potladhruval/Beamsteering_Network/README.md

# Beamsteering_Network
This project consists of beamforming array design consisting of the network of Phase shifters, Low Noise Amplifiers, and Via-fed Patch antennas to form the building blocks of the beamsteering network
