potladhruval/Beamsteering_Network/Via-Fed Patch antenna/Patch Antenna Design Project.pdf

## Patch Antenna Design Project August 21, 2023 Dhruval Potla, student

## Assignment

## Design

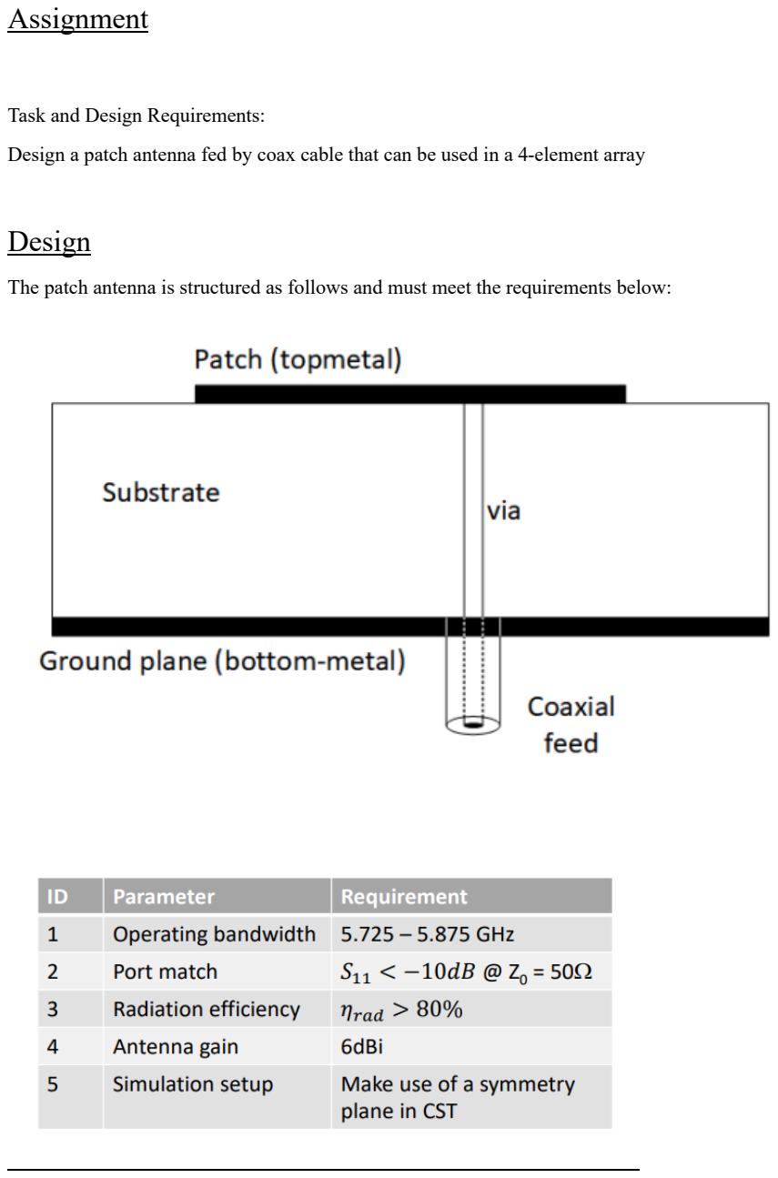
[picture p1: page 2]

Task and Design Requirements:

Design a patch antenna fed by coax cable that can be used in a 4-element array

The patch antenna is structured as follows and must meet the requirements below:

The design equations are as follows as found at www.everythingrf.com/microstrip-patch-antennacalculator:

The Microstrip Patch Antenna Calculation Process

Step 1: Calculation of the Width (W) -
Step 2: Calculation of the Effective Dielectric Constant. This is based on the height, dielectric constant of the dielectric and the calculated width of the patch antenna.
Step 3: Calculation of the Effective length
Step 4: Calculation of the length extension ΔL
Step 5: Calculation of actual length of the patch

Where the following parameters are used

f0 is the Resonance Frequency

W is the Width of the Patch

L is the Length of the Patch

h is the thickness

εr is the relative Permittivity of the dielectric substrate

c is the Speed of light: 3 x 10⁸

For this design, the center frequency equals 5.8 GHz, and the substrate is Rogers 4350B with a height of 1.52 mm and an effecCve dielectric constant of 3.66.
AFer inpuGng those parameters, the following dimensions were calculated:
Name | Value Unit
"--Antenna Dimensions"
patchX | 1.657 cm
patchY | 1.247 cm
"--Substrate Dimensions"
subH | 0.152 cm
subX | 3.5 cm
subY | 2.9 cm
"--Feed Dimensions"
feedX | 0 | cm
feedY | 0.35 cm
coax_inner_rad 0.043 cm
coax_outer_rad 0.147 cm
feedLength 0.86 cm

The following picture is the HFSS patch antenna:

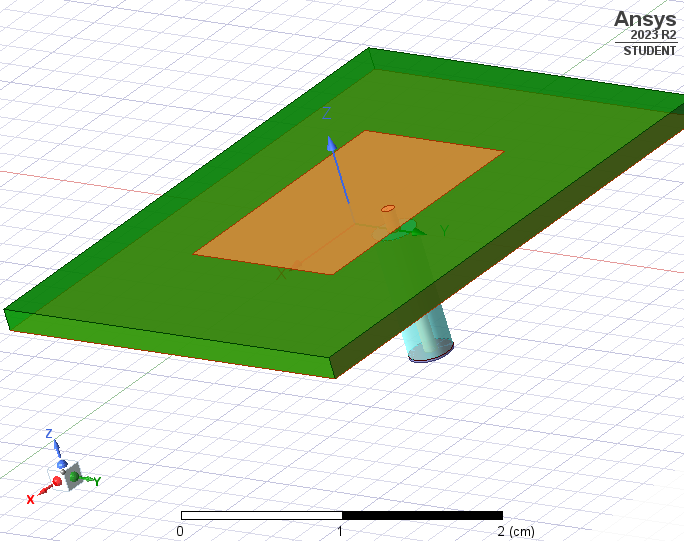
[picture p2: figure]

## Analysis

Using HFSS, the following graphs were generated. The only difficulty was the location of the feed, which was first put at 0.23 cm, which resulted in a very high return loss. After some adjustment, it was found that a location of 0.35 cm brought the return loss to under -10dB through the operating region (5.725 to 5.875 GHz):

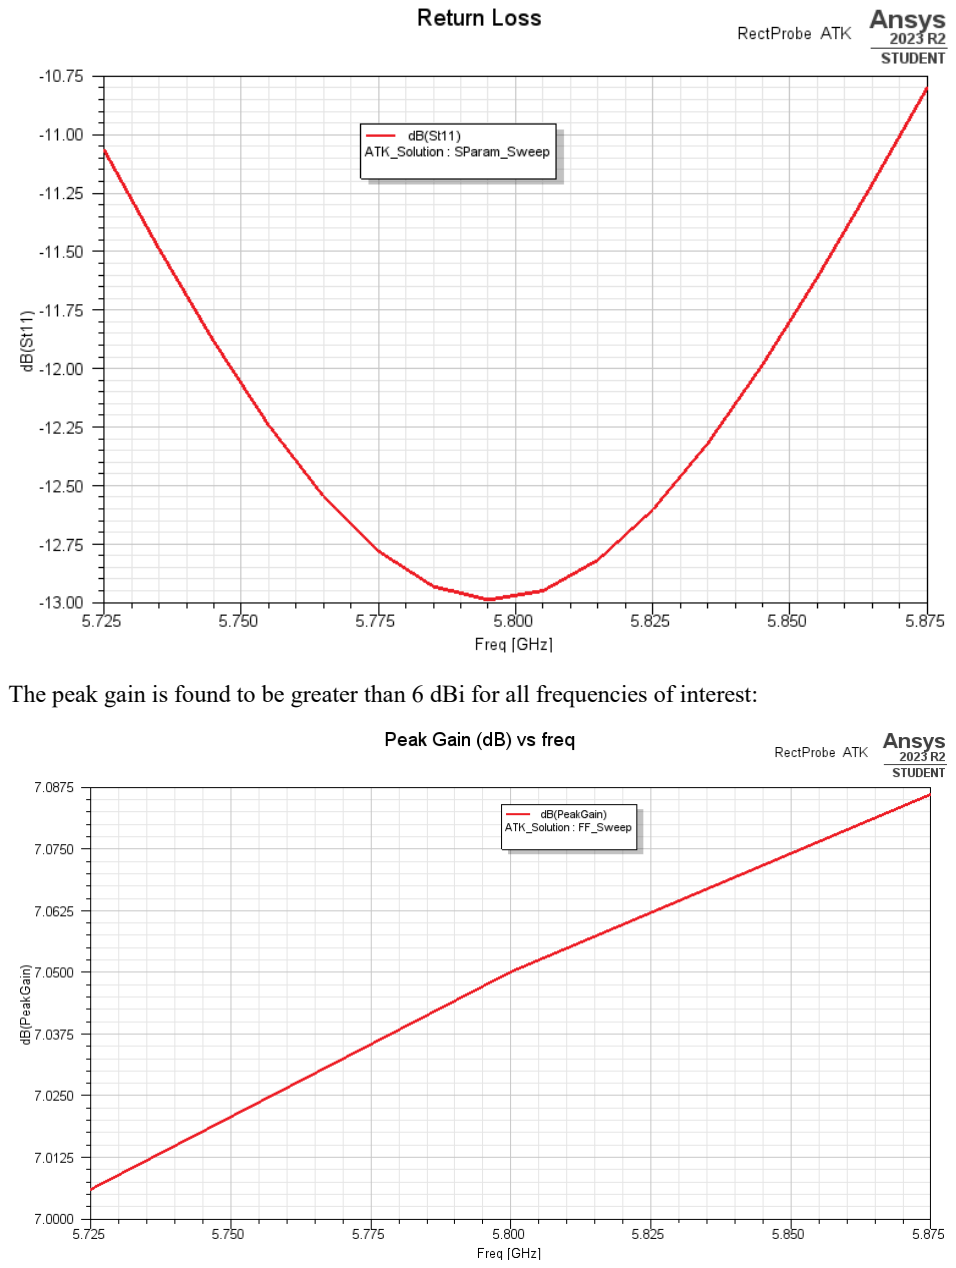
[picture p3: page 6]

The peak gain is found to be greater than 6 dBi for all frequencies of interest:

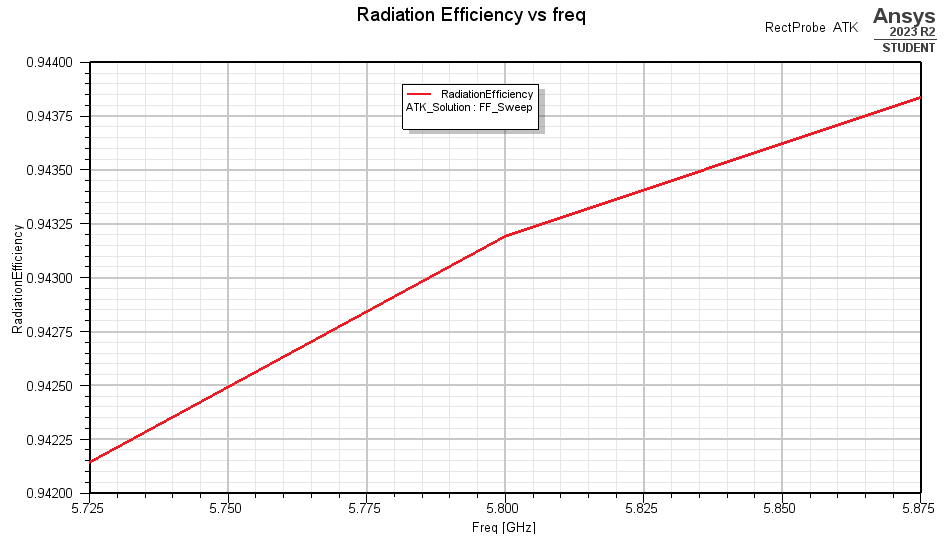
[picture p4: figure]

The above plot shows that the radiation efficiency is well above 80% for all frequencies of interest.

## Conclusion

A patch antenna meeting the given requirements was successfully designed in HFSS (as the links to the other software packages were broken), after the adjustment was made to the location of the input coax connector (moved from 0.23 mm to 0.35 mm from the center of the patch. This simulation is an estimate of behavior, which does not include, for example, fringing effects and mutual coupling among antennas (this is designed to be part of a 4-element phased array).

## References

A.B Smolder, H. J. Visser, U. Johannsen. Modern Antennas and Microwave Circuits: A complete master-level course. Version September 2020. Eindhoven University of Technology.

www.everythingrf.com/rf_calculators/microstrip-patch-antenna-calculator/
